rafaeloelo/CurrentDongle/kicad/miernik.kicad_pcb

## KiCad design kicad/miernik.kicad_pcb (2026-11-03)

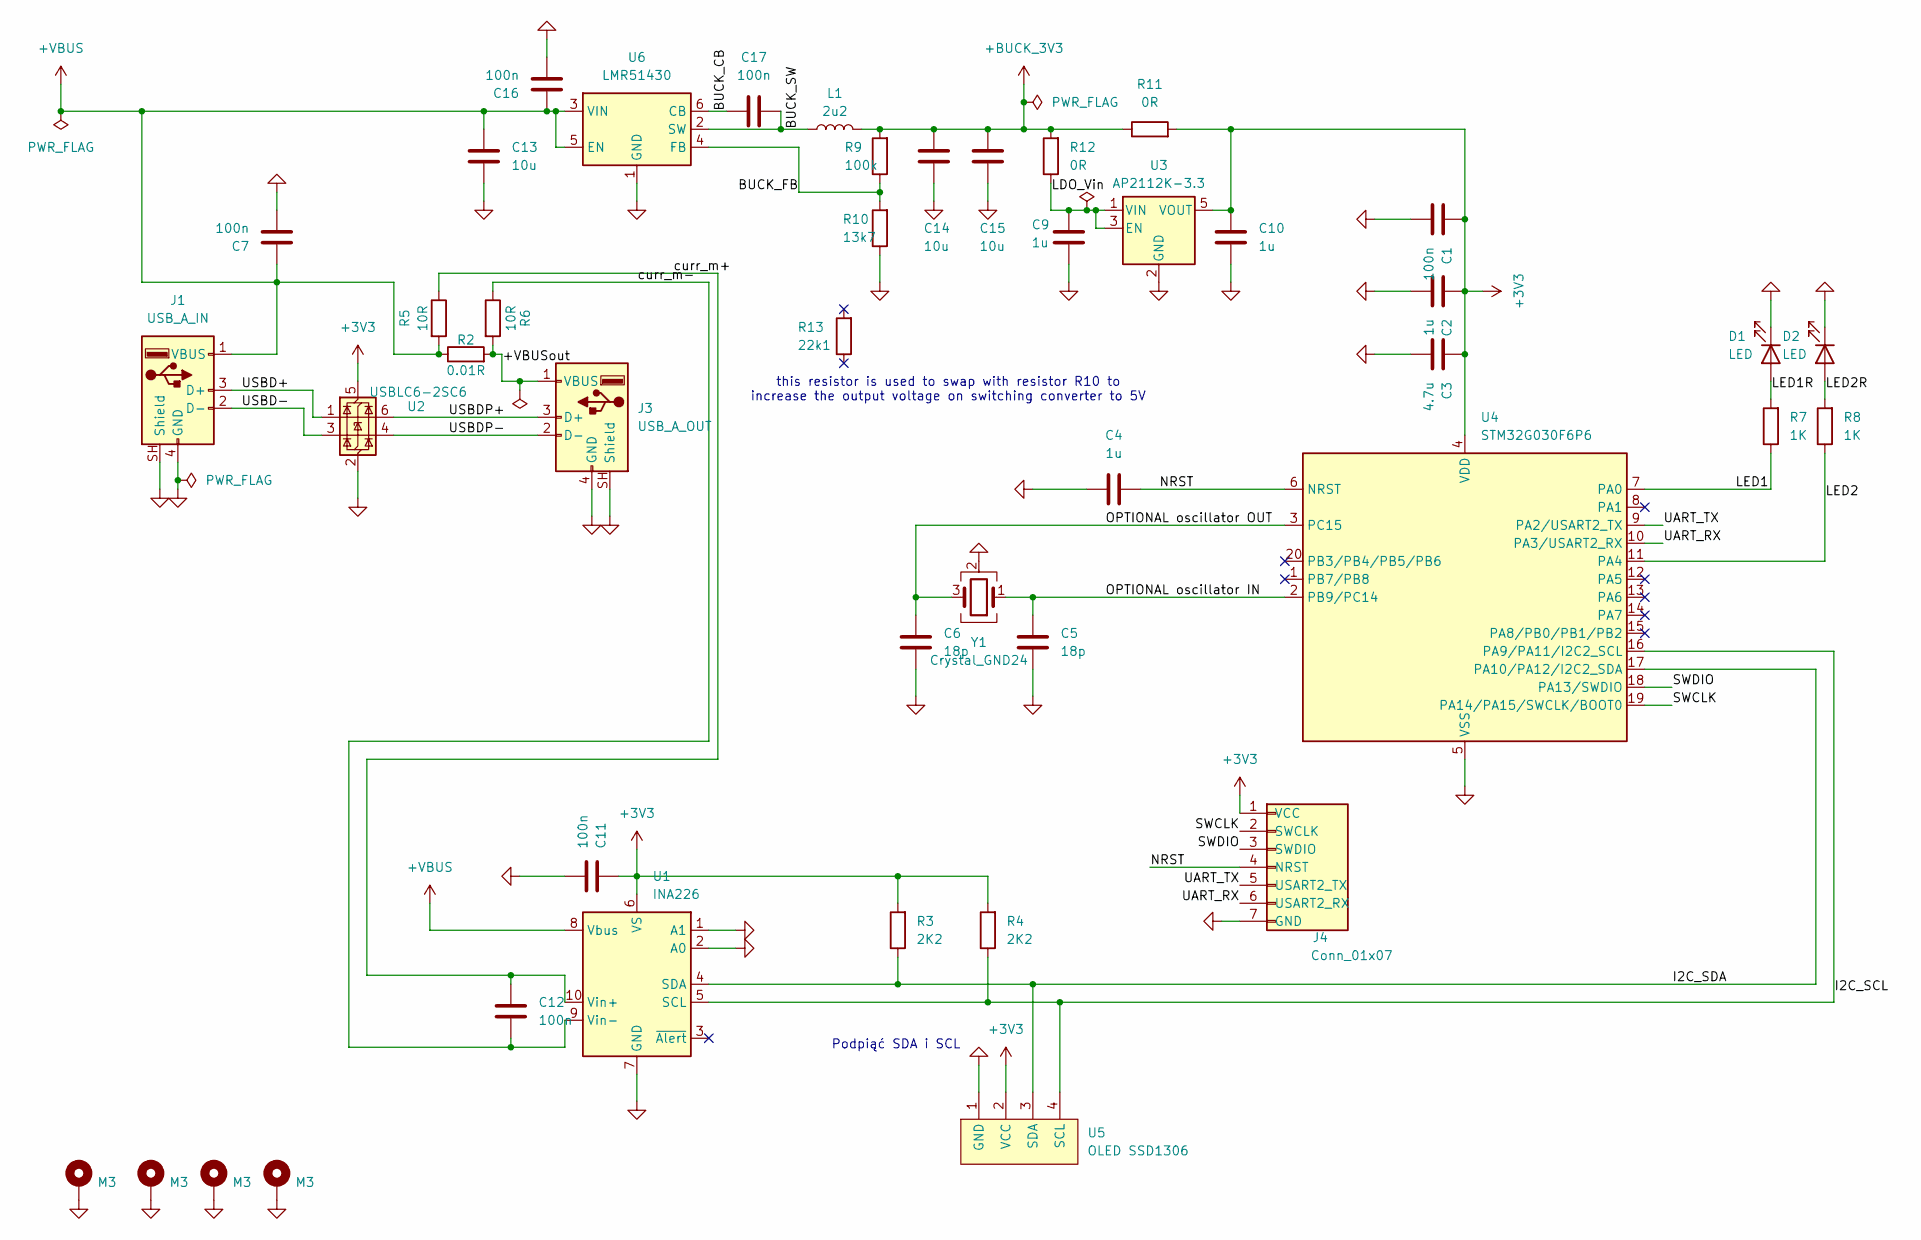
[picture p1: schematic miernik.kicad_sch, Miernik USB]

Parts:
C1, C7, C11, C12, C16, C17: 100n; C_0805_2012Metric
C2, C4, C9, C10: 1u; C_0805_2012Metric
C3: 4.7u; C_0805_2012Metric
C5, C6: 18p; C_0805_2012Metric
C13, C14, C15: 10u; C_0805_2012Metric
D1, D2: LED; LED_0805_2012Metric_Pad1.15x1.40mm_HandSolder
J1: USB_A_IN; USB_A_Molex_48037-2200_Horizontal
J3: USB_A_OUT; USB_A_Molex_67643_Horizontal
J4: Conn_01x07; PinSocket_1x07_P2.54mm_Vertical
L1: 2u2; L_0805_2012Metric_Pad1.05x1.20mm_HandSolder
MH1, MH2, MH3, MH4: M3; MountingHole_3.2mm_M3_Pad_Via
R2: 0.01R; R_2512_6332Metric_Pad1.40x3.35mm_HandSolder
R3, R4: 2K2; R_0805_2012Metric_Pad1.20x1.40mm_HandSolder
R5, R6: 10R; R_0805_2012Metric_Pad1.20x1.40mm_HandSolder
R7, R8: 1K; R_0805_2012Metric_Pad1.20x1.40mm_HandSolder
R9: 100k; R_0805_2012Metric_Pad1.20x1.40mm_HandSolder
R10: 13k7; R_0805_2012Metric_Pad1.20x1.40mm_HandSolder
R11, R12: 0R; R_0805_2012Metric_Pad1.20x1.40mm_HandSolder
R13: 22k1; R_0805_2012Metric_Pad1.20x1.40mm_HandSolder
U1: INA226; TSSOP-10_3x3mm_P0.5mm
U2: USBLC6-2SC6; SOT-23-6
U3: AP2112K-3.3; SOT-23-5
U4: STM32G030F6P6; TSSOP-20_4.4x6.5mm_P0.65mm
U5: OLED SSD1306; 128x64OLED
U6: LMR51430; SOT-23-6
Y1: Crystal_GND24; Crystal_SMD_3225-4Pin_3.2x2.5mm_HandSoldering

Connections:
+3V3: C1.1, C2.1, C3.1, C10.1, C11.1, J4.1 (VCC), R3.2, R4.2, R11.2, U1.6 (VS), U2.5 (VBUS), U3.5 (VOUT), U4.4 (VDD), U5.2 (VCC)
+BUCK_3V3: C14.1, C15.1, L1.2, R9.2, R11.1, R12.2
+VBUS: C7.1, C13.1, C16.1, J1.1 (VBUS), R2.1, R5.2, U1.8 (Vbus), U6.3 (VIN), U6.5 (EN)
/+VBUSout: J3.1 (VBUS), R2.2, R6.2
/BUCK_CB: C17.2, U6.6 (CB)
/BUCK_FB: R9.1, R10.2, U6.4 (FB)
/BUCK_SW: C17.1, L1.1, U6.2 (SW)
/I2C_SCL: R4.1, U1.5 (SCL), U4.16 (PA9/PA11/I2C2_SCL), U5.4 (SCL)
/I2C_SDA: R3.1, U1.4 (SDA), U4.17 (PA10/PA12/I2C2_SDA), U5.3 (SDA)
/LDO_Vin: C9.1, R12.1, U3.1 (VIN), U3.3 (EN)
/LED1: R7.1, U4.7 (PA0)
/LED1R: D1.2 (A), R7.2
/LED2: R8.1, U4.11 (PA4)
/LED2R: D2.2 (A), R8.2
/NRST: C4.1, J4.4 (NRST), U4.6 (NRST)
/OPTIONAL oscillator IN: C5.1, U4.2 (PB9/PC14), Y1.1
/OPTIONAL oscillator OUT: C6.1, U4.3 (PC15), Y1.3
/SWCLK: J4.2 (SWCLK), U4.19 (PA14/PA15/SWCLK/BOOT0)
/SWDIO: J4.3 (SWDIO), U4.18 (PA13/SWDIO)
/UART_RX: J4.6 (USART2_RX), U4.10 (PA3/USART2_RX)
/UART_TX: J4.5 (USART2_TX), U4.9 (PA2/USART2_TX)
/USBD+: J1.3 (D+), U2.1 (I/O1)
/USBD-: J1.2 (D-), U2.3 (I/O2)
/USBDP+: J3.3 (D+), U2.6 (I/O1)
/USBDP-: J3.2 (D-), U2.4 (I/O2)
/curr_m+: C12.1, R5.1, U1.10 (Vin+)
/curr_m-: C12.2, R6.1, U1.9 (Vin-)
GND: C1.2, C2.2, C3.2, C4.2, C5.2, C6.2, C7.2, C9.2, C10.2, C11.2, C13.2, C14.2, C15.2, C16.2, D1.1 (K), D2.1 (K), J1.4 (GND), J1.SH (Shield), J3.4 (GND), J3.SH (Shield), J4.7 (GND), MH1.1 (1_1), MH2.1 (1_1), MH3.1 (1_1), MH4.1 (1_1), R10.1, U1.1 (A1), U1.2 (A0), U1.7 (GND), U2.2 (GND), U3.2 (GND), U4.5 (VSS), U5.1 (GND), U6.1 (GND), Y1.2 (G), Y1.4 (G)

Notes on the sheet:
this resistor is used to swap with resistor R10 to increase the output voltage on switching converter to 5V
Podpiąć SDA i SCL

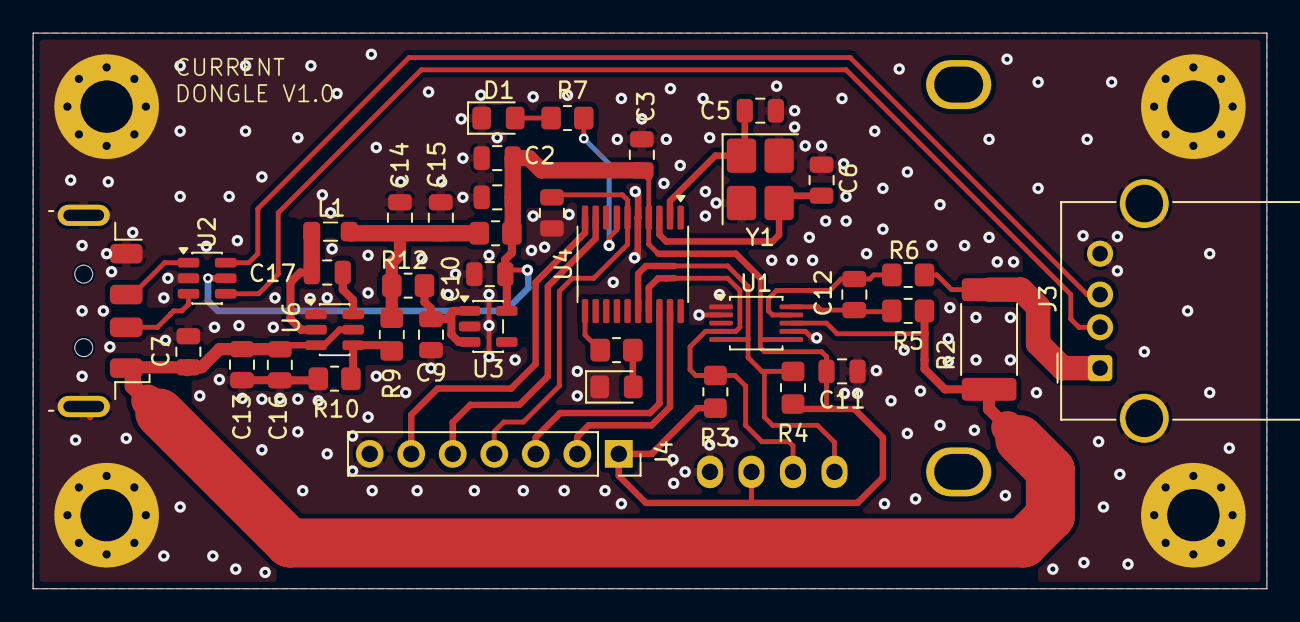
[picture p2: board miernik.kicad_pcb from above]

Board: 2 copper layers, 75.5 x 34.0 mm, 44 parts (1 on the bottom side), 28 nets.
