rafaeloelo/CurrentDongle/firmware/miernik/miernik.ioc

Mcu.UserName=STM32G030F6Px
PA0.GPIO_Label=LED1
PA0.Signal=GPIO_Output
PA13.Signal=SYS_SWDIO
PA14-BOOT0.Signal=SYS_SWCLK
PA2.Signal=USART2_TX
PA3.Signal=USART2_RX
PA4.GPIO_Label=LED2
PA4.Signal=GPIO_Output
