rafaeloelo/CurrentDongle/firmware/miernik/Core/Inc/main.h

#define LED1_Pin GPIO_PIN_0
#define LED1_GPIO_Port GPIOA
#define LED2_Pin GPIO_PIN_4
#define LED2_GPIO_Port GPIOA
