rafaeloelo/CurrentDongle/(commit log)

2026-09-13 Pierwsze dodanie plików. Schemat, bez wyświetlacza, nie stworzono jeszcze PCB, do zweryfikowania czy wszystkie połączenia są ok.
    [miernik.kicad_pcb, miernik.kicad_sch]
2026-09-15 Wszystkie połączenia, konektor 1x7 goldpin do komunikacji
    [miernik.kicad_sch]
2026-09-16 Schemat done. Started PCB layout.
    [miernik.kicad_pcb, miernik.kicad_sch]
2026-09-18 PCB layout continue
    [miernik.kicad_pcb, miernik.kicad_sch]
2026-09-24 Przetwornica
    dodana przetwornica, do zdefiniowania wartosci pasywów dookoła buck_converter, do zdefiniowanie ewentualne LDO, dodano mozliwosc zasilania bezposrednio z przetwornicy lub jesli bedzie za wysokie napiecie to jeszcze bedzie podane na LDO, musi byc zaprojektowana przetwornica na troche wyzsze napiecie just in case
    [miernik.kicad_pcb, miernik.kicad_sch]
2026-09-25 switching converter done
    all components include in electrical diagram
    [miernik.kicad_pcb, miernik.kicad_sch]
2026-09-25 diagram done, corrected all mistakes
    [miernik.kicad_sch]
2026-09-26 partial placement on PCB
    [miernik.kicad_pcb, miernik.kicad_sch]
2026-09-26 holes to place left
    [miernik.kicad_pcb, miernik.kicad_sch]
2026-09-26 first paths done
    [miernik.kicad_pcb]
2026-09-27 OLED corrected
    created mh for OLED
    [miernik.kicad_pcb]
2026-09-28 PCB routing completed
    [miernik.kicad_pcb, miernik.kicad_sch]
2026-09-29 Corrected routing, no routes to GND
    [miernik.kicad_pcb]
2026-09-29 Layout done
    [miernik.kicad_pcb]
2026-09-29 GND menaged
    [miernik.kicad_pcb]
2026-09-29 Rule check completed
    [miernik.kicad_pcb, miernik.kicad_sch]
2026-10-06 corrected routing VBUS U2
    [miernik.kicad_pcb]
2026-10-22 BLINK
    pierszy najprostszy program, żeby sprawdzić czy wszystko śmiga i działa.
    Dioda miga!
    [miernik.kicad_pcb, miernik.kicad_sch]
2026-10-24 INA226 connected, OLED display string
    Oba LED informujące o komunikacji, świecą ciągle - oba urządzenia są połączone po I2C
2026-10-25 OLED showed Voltage
    OLED showing voltage. It is needed to check the real value with osciloscope.
    Code to correction, there are many copies of same chunks.
    [main.c]
2026-10-31 DONE. Correct code, INA shows average values
    Some chunks of the code could be corrected. There are some repetitions.
    Eventually the device is working correctly.
    [main.c]
2026-11-03 corrected 3D view
    added 3D model to usb conn
    [miernik.kicad_pcb]
